L71/XOR/README.md

XOR
===

XOR logic gate based noise generator. 2x oscillators with voltage control, 3 oscillators with manual control only.
Two outputs, first one from VCO1 and two other oscillators, the second one adds VCO2 and another manually controlled oscillator into the mix.
