L71/XOR/XOR.brd

## EAGLE design XOR.brd (2015-06-29)

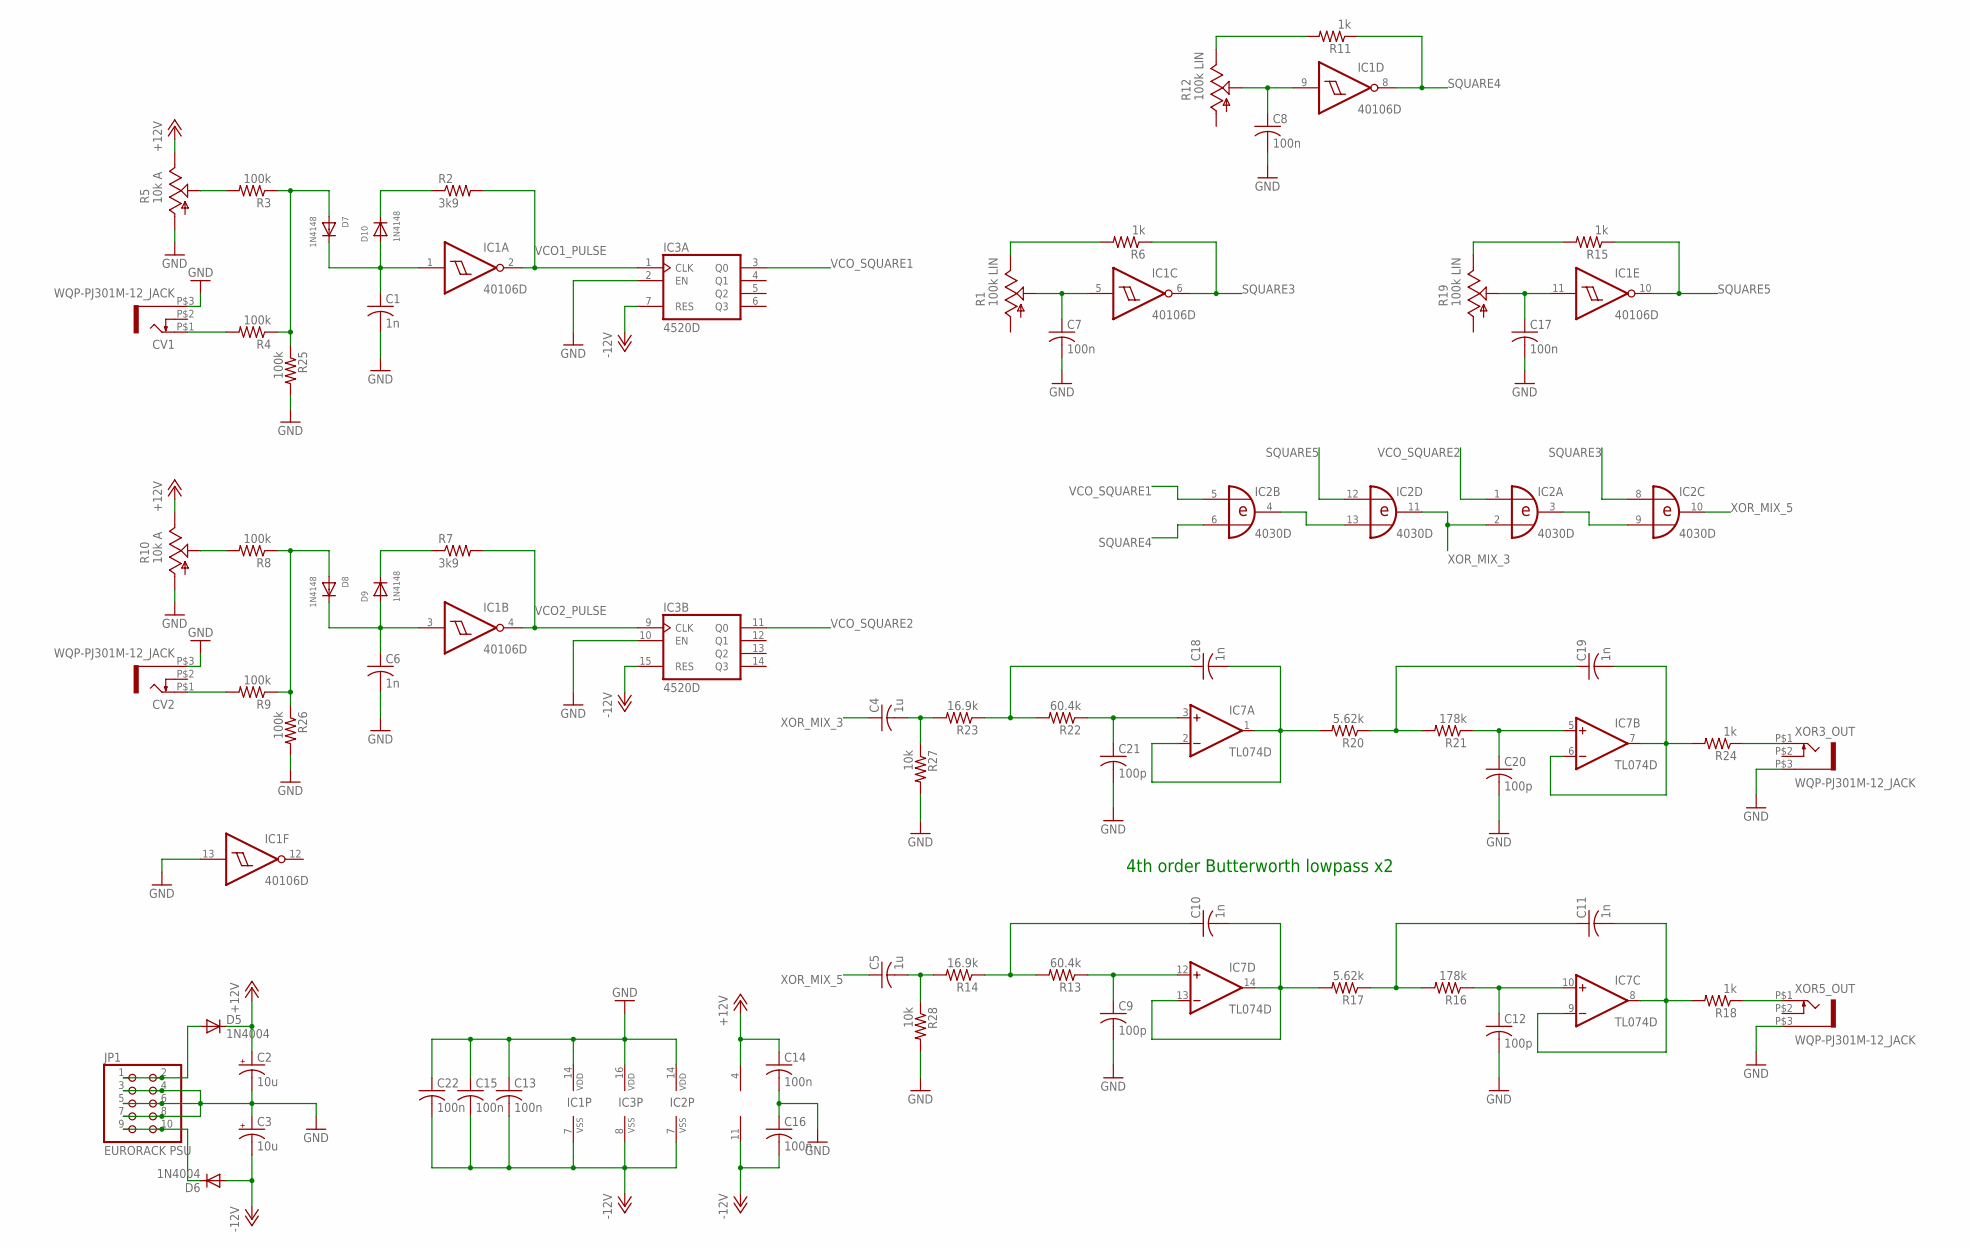
[picture p1: schematic XOR.sch]

Parts:
C1, C6, C10, C11, C18, C19: 1n; C0603K
C2, C3: 10u; PANASONIC_D
C4, C5: 1u; C0603K
C7, C8, C13, C14, C15, C16, C17, C22: 100n; C0603K
C9, C12, C20, C21: 100p; C0603K
CV1, CV2: WQP-PJ301M-12_JACK
D5, D6: 1N4004; DO214AA
D7, D8, D9, D10: 1N4148; SOD-323F
IC1: 40106D; SO14
IC2: 4030D; SO14
IC3: 4520D; SO16
IC7: TL074D; SO14
JP1: EURORACK PSU; 2X05
R1, R12, R19: 100k LIN; ALPS_POT_VERTICAL
R2, R7: 3k9; R0603
R3, R4, R8, R9, R25, R26: 100k; R0603
R5, R10: 10k A; ALPS_POT_VERTICAL
R6, R11, R15, R18, R24: 1k; R0603
R13, R22: 60.4k; R0603
R14, R23: 16.9k; R0603
R16, R21: 178k; R0603
R17, R20: 5.62k; R0603
R27, R28: 10k; R0603
XOR3_OUT, XOR5_OUT: WQP-PJ301M-12_JACK

Connections:
+12V: C2.+, C14.1, D5.C, IC7.4 (V+), R5.P$1 (E), R10.P$1 (E)
-12V: C3.-, C13.2, C15.2, C16.2, C22.2, D6.A, IC1.7 (VSS), IC2.7 (VSS), IC3.7 (RES), IC3.8 (VSS), IC3.15 (RES), IC7.11 (V-)
GND: C1.2, C2.-, C3.+, C6.2, C7.2, C8.2, C9.2, C12.2, C13.1, C14.2, C15.1, C16.1, C17.2, C20.2, C21.2, C22.1, CV1.P$3 (1), CV2.P$3 (1), IC1.13 (I), IC1.14 (VDD), IC2.14 (VDD), IC3.2 (EN), IC3.10 (EN), IC3.16 (VDD), JP1.3, JP1.4, JP1.5, JP1.6, JP1.7, JP1.8, R5.P$3 (A), R10.P$3 (A), R25.2, R26.2, R27.2, R28.2, XOR3_OUT.P$3 (1), XOR5_OUT.P$3 (1)
unnamed: R3.2, R5.P$2 (S)
unnamed: CV1.P$1 (2), R4.2
unnamed: D7.A, R3.1, R4.1, R25.1
unnamed: C1.1, D7.C, D10.A, IC1.1 (I)
unnamed: D10.C, R2.1
unnamed: R1.P$1 (E), R6.2
unnamed: R8.2, R10.P$2 (S)
unnamed: D6.C, JP1.9, JP1.10
unnamed: D5.A, JP1.1, JP1.2
unnamed: IC2.3 (O), IC2.9 (I1)
unnamed: R11.2, R12.P$1 (E)
unnamed: C6.1, D8.C, D9.A, IC1.3 (I)
unnamed: C7.1, IC1.5 (I), R1.P$2 (S)
unnamed: D9.C, R7.1
unnamed: C12.1, IC7.10 (+IN), R16.1
unnamed: D8.A, R8.1, R9.1, R26.1
unnamed: C10.2, IC7.13 (-IN), IC7.14 (OUT), R17.2
unnamed: CV2.P$1 (2), R9.2
unnamed: C8.1, IC1.9 (I), R12.P$2 (S)
unnamed: C10.1, R13.2, R14.1
unnamed: C9.1, IC7.12 (+IN), R13.1
unnamed: R18.1, XOR5_OUT.P$1 (2)
unnamed: C17.1, IC1.11 (I), R19.P$2 (S)
unnamed: IC2.4 (O), IC2.13 (I1)
unnamed: R15.2, R19.P$1 (E)
unnamed: C18.1, R22.2, R23.1
unnamed: C18.2, IC7.1 (OUT), IC7.2 (-IN), R20.2
unnamed: C21.1, IC7.3 (+IN), R22.1
unnamed: C11.1, R16.2, R17.1
unnamed: C11.2, IC7.8 (OUT), IC7.9 (-IN), R18.2
unnamed: C4.2, R23.2, R27.1
unnamed: C19.1, R20.1, R21.2
unnamed: C20.1, IC7.5 (+IN), R21.1
unnamed: C19.2, IC7.6 (-IN), IC7.7 (OUT), R24.2
unnamed: R24.1, XOR3_OUT.P$1 (2)
unnamed: C5.2, R14.2, R28.1
SQUARE3: IC1.6 (O), IC2.8 (I0), R6.1
SQUARE4: IC1.8 (O), IC2.6 (I1), R11.1
SQUARE5: IC1.10 (O), IC2.12 (I0), R15.1
VCO1_PULSE: IC1.2 (O), IC3.1 (CLK), R2.2
VCO2_PULSE: IC1.4 (O), IC3.9 (CLK), R7.2
VCO_SQUARE1: IC2.5 (I0), IC3.3 (Q0)
VCO_SQUARE2: IC2.1 (I0), IC3.11 (Q0)
XOR_MIX_3: C4.1, IC2.2 (I1), IC2.11 (O)
XOR_MIX_5: C5.1, IC2.10 (O)

Notes on the sheet:
4th order Butterworth lowpass x2

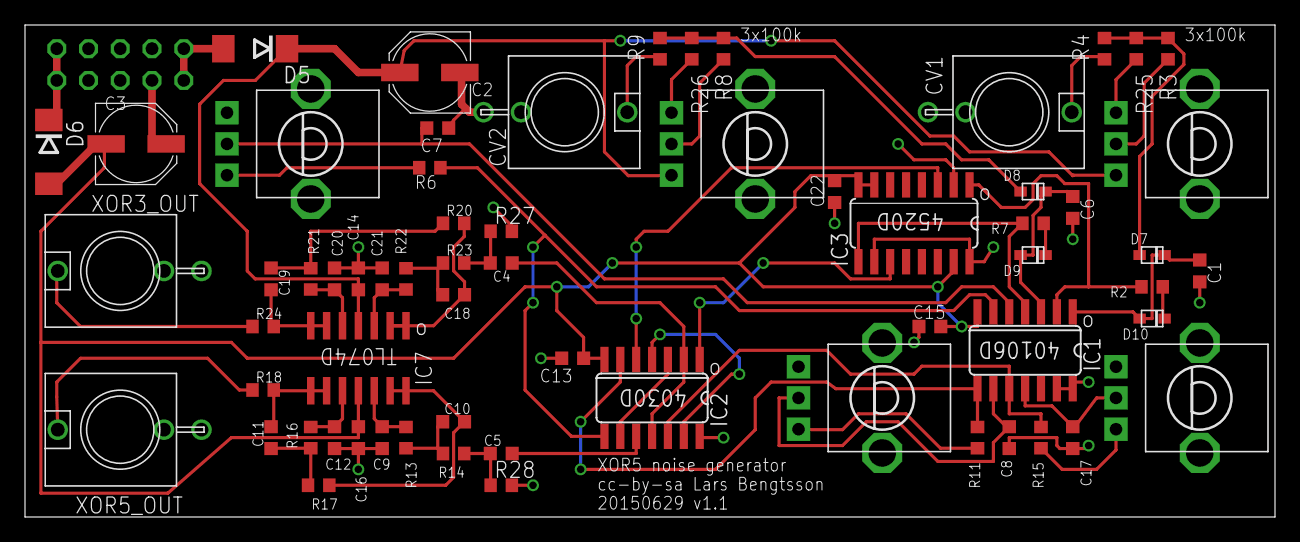
[picture p2: board XOR.brd from above]

Board: 2 copper layers, 100.0 x 39.4 mm, 65 parts (1 on the bottom side), 48 nets.
