L71/XOR/(commit log)

2015-06-06 Initial upload.
    [XOR.sch]
2015-06-06 added decoupling caps at logic ICs.
    [XOR.sch]
2015-06-06 initial upload of board file.
    [XOR.brd]
2015-06-07 Changed PSU diode type/footprint. Not fits DO214 package types. PCB: moved ICs a bit, better fit for CV in jack 1.
    [XOR.brd, XOR.sch]
2015-06-11 Changed order in which oscillators are XORed together. Use bigger footprint for PSU smoothing caps. Moved XOR IC a bit & rerouted.
    [XOR.brd, XOR.sch]
2015-06-29 Added 2x10k resistors that pulls the filter inputs to ground (got DC offset problem on the filter outputs without them).
    [XOR.brd, XOR.sch]
2015-06-29 Added dot at pin 1 of the ICs.
    [XOR.brd]
2016-04-06 Updated artwork a bit, added algorithm info to panel. Adjusted holes. Should fit well in racks w 3mm screw rails now.
