L71/XOR/(notices)

Notices in the files:
XOR.brd:
cc-by-sa Lars Bengtsson
cc-by-sa 2015 Lars Bengtsson
